iafilm-makers/Mod-8-film/README.md

The Mod-8 Project aims to improve Super-8mm filming, and rescue old cameras with dead motors:<br />
Use modern drives, eg stepper motors, so we can eliminate the sprocket holes. <br />
That saves space. Use that space to go 16:9 widescreen.<br />
Modify and Modernise so call it Mod-8.<br /><br />

Code is licensed under the MIT license<br />
Documents and designs are licensed under CC-BY-4.0<br />
