iafilm-makers/Mod-8-film/Mod-8-Camera-Circuits.pdf

Camera “Prototype One” – modified Sankyo 620 Supertronic.

Version 01 of 17 May 2026

This document covers circuits and circuit building.

See other document “Mod-8 - Super-8mm Camera Mods.pdf” for the craft of camera modification.

Photo: This is a complex circuit!
It worked well for me to build by planning with simpler diagrams of separate sections.

Use of old bell wire. I have many scrap boxes of parts from parents, grandparents and other extended family. This included bell wire where the core is a single thick copper wire. This is rigid and a tight fit into breadboard holes. I think that this gives robust breadboard prototyping for a working portable camera.

Wire colours convention:
I follow this by colouring white bell wire with permanent marker pen.
Implementation is not quite perfect. On the TODO list is painting some wires.
Red | Vcc positive – camera original power supply of 6 x NiMH batteries giving about 7.5V
Orange | 5V digital electronics power
Yellow | INPUTs into MCU
White | OUTPUTs from MCU

A4988 stepper
motor driver for
film advance.

MCU “Nucleo”
STM32-F303K8

“debouncing” for
shutter contact
breaker.

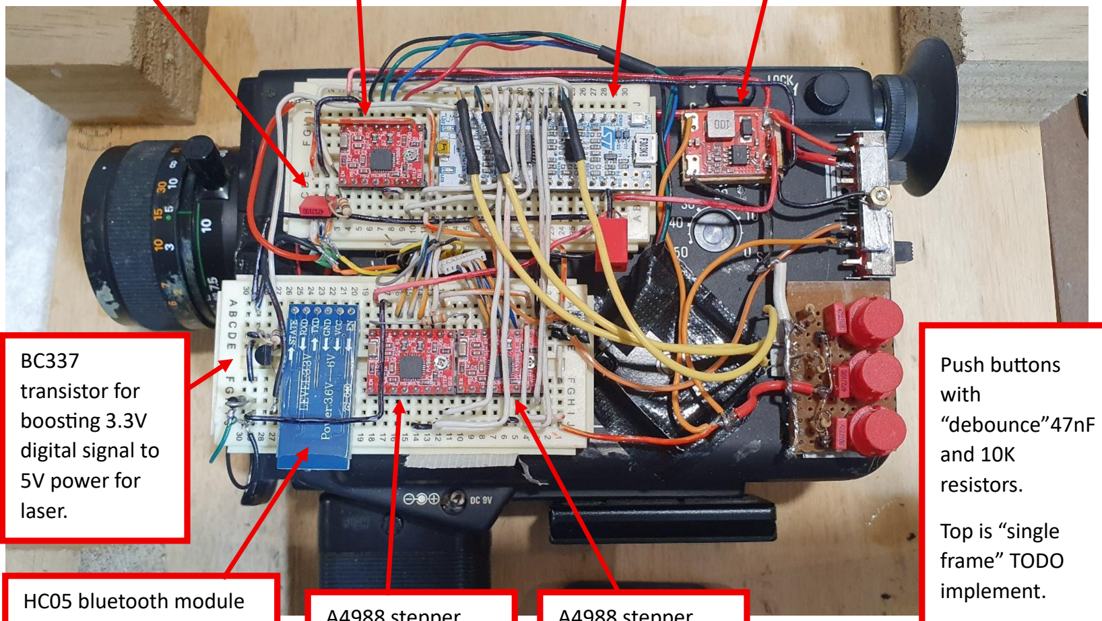
[picture p1: figure]
BC337 transistor for boosting 3.3V digital signal to 5V power for laser.; HC05 bluetooth module; Push buttons with “debounce”47nF and 10K resistors.; Top is “single frame” TODO implement.

not connected yet.
For future control and
monitoring by mobile
phone.

A4988 stepper
motor driver for
shutter motor.

A4988 stepper
motor driver for
aperture control.

DFRobot DFR0571 Buck
5V Power Module

Lower two are
aperture open
and close.

I found this useful to print on paper as the main diagram to work from

ADVANCE_SIGNAL = 2;

SINGLE_FRAME = 3;

STEP_APERTURE = 4;

DIR_APERTURE = 5;

STEP_DRIVE = 6;

DIR_DRIVE = 7;

STEP_SHUTTER = 8;

DIR_SHUTTER = 9;

REGISTRATION_MARK
= 10;

APERTURE_PLUS
= 11;
APERTURE_MINUS
= 12;

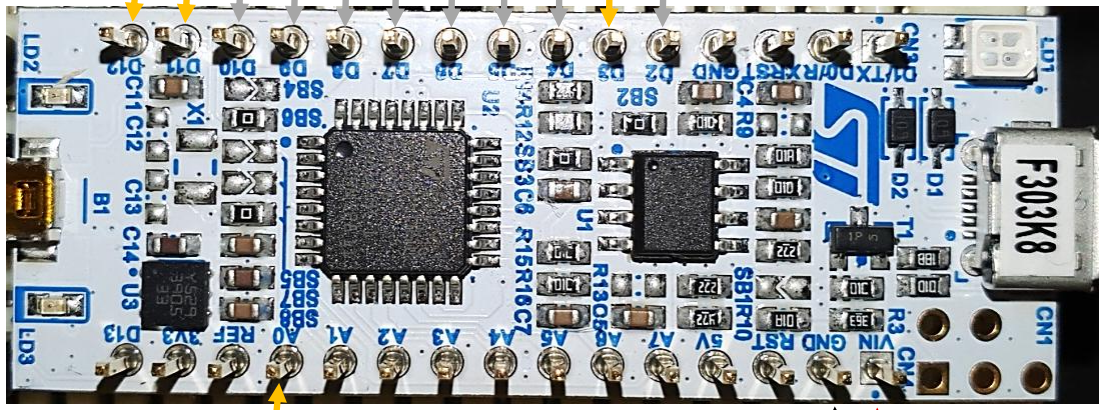
[picture p2: figure]

RUN_SWITCH = A0;

GND VIN

Circuit diagram, partial for clarity

Showing detail wiring of A4988 for the main film drive. The others are similar.

Wire colours:

Red | Vcc positive – camera original power supply of 6 x NiMH batteries giving about 7.5V
Orange | 5V digital electronics power
White | OUTPUTs from MCU

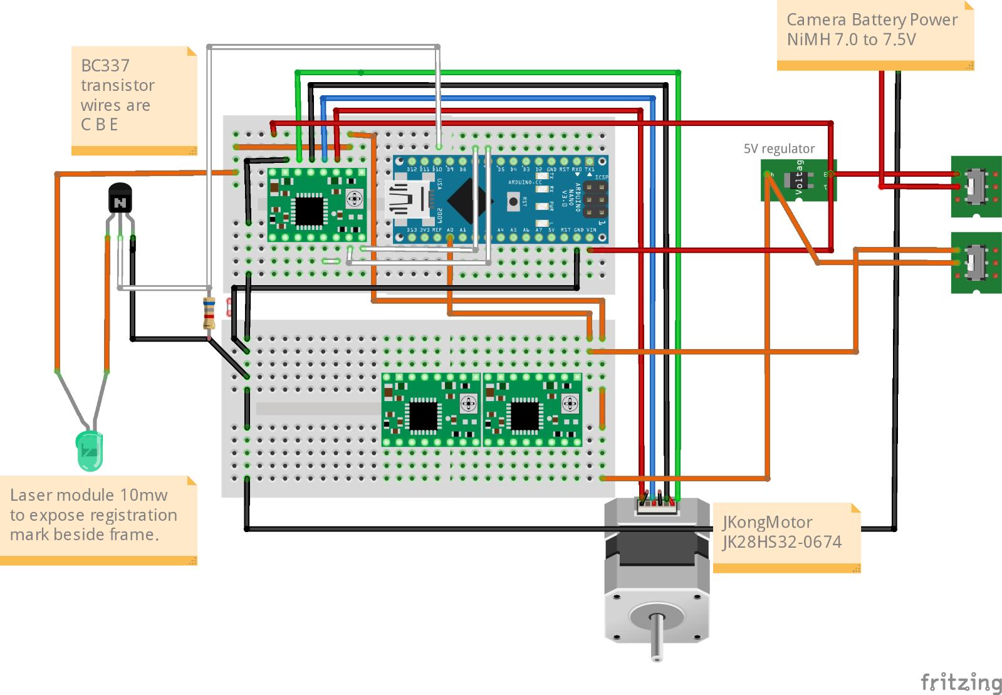
[picture p3: figure]
