iafilm-makers/Mod-8-film/Mod-8-Super-8mm Camera Mods.pdf

Mod-8 - Super-8mm Camera Mods
Example – “Sankyo 620 Supertronic”.
v01 – 2026-03-29
© 2026 by John Calder. Licensed under CC BY 4.0 Creative Commons Attribution.
More at the end of this document. In brief: cite mod-8-film.com
GUIDELINES ONLY: this what works for me but this is only one of many inputs and experiences that you need to develop your skills and capabilities.
SAFETY: Follow tool safety instructions, e.g. wear eye protection when cutting, drilling and grinding. Think “where is this going if it slips” e.g. cut in a direction away from yourself.
Wear protection e.g. gloves when handling glues, cleaning liquids and other things bad for our skin. Audiences:
- “Mod-8” - Makers modifying cameras to full “Mod-8” specs.
This extends the image size from 5.7mm x 4.1mm to 7.3mm to 4.1mm
and widens the range of film sources because we no longer need sprocket holes.
- “Upgrade” - Makers and camera owners using “spinoff discoveries” from the Mod-8 project to rebuild cameras to continue operating with classic format Super-8mm film.
In both cases we replace 45-60 year old motors, actuators and circuit boards with modern stepper motors and Arduino-programmed development boards. This gives the camera crystal-controlled accurate speed because development boards include accurate timing via crystal.
First up is a Sankyo 620 because it happens to be my available dead camera.
It is complex, advanced and compact. I am guessing that most cameras will be easier to work with than this one. However it does have some pleasant surprises.
Overview
Audience | Task | Case Sankyo 620
Both | Replace main drive motor | Easy Vitech 20BY Mini stepper motor is slightly smaller than the original motor. Its gear wheel matches the teeth of the Sankyo drive. It is an easy “drop in” replacement.
Both | Aperture control - manual | Intermediate Replace actuator with a micro stepper motor. Lucky that this comes with a gear wheel that matches the teeth of the Sankyo aperture drive. Note: some older simpler cameras have manual operation that needs no change.
Both | Aperture control – automatic - OPTIONAL | Not attempted at time of writing. I plan to use a separate light meter. Sankyo 620 has a sensor. TODO analyse what it does. It could be a photoresistor, photodiode or phototransistor.

Mod-8 | Widen the gate from 5.7mm to 7.3mm. The height stays at 4.1mm | Easy (as in surprisingly easy) I made a tool out of basswood, sanded it to 4.1 mm thick, glued sandpaper on the edge and got to work sanding evenly on both sides.
Mod-8 | Remove film advance claw and related mechanical parts | Challenge Sankyo 620 has a complex drive to provide a “lap dissolve” special effect. Need to identify, remove and scrap most of those parts and superglue the film take-up tailshaft into its normal run position.
Mod-8 | Provide a timing device on the shutter drive to trigger film advance | Easy Sankyo 620 already has a “flash trigger” switch that can do this. The only change needed is to reposition the timing gear to “fire” on shutter close rather than shutter open. This is a lot like configuring timing gears on classic cars and motorbikes.
Mod-8 | Convert sound drive to film transport drive | Intermediate Remove guides and sound heads. Remove capstan and pulley – replace with a stepper motor and shaft sleeve.
Mod-8 | Modify film cartridge for new film transport and reloadability. | Intermediate Add idler pulley and precision-drill registration dot hole
Mod-8 | Setup a light source to expose a registration mark beside each film frame. | Intermediate I zap the film with a very low power 10mW laser module of the kind used for laser pointers. Sankyo 620 has a sound drive motor that is no longer needed, remove that to make a good space for the laser. I needed to create a jig to precisely drill a 0.5mm diameter hole in the lower front of the film cartridge.

Toolkit
My setup is an average home workbench with common small tools, especially:
- Jewellers screwdrivers
- Tweezers – thin nose
- Electric drill and/or Rotary Tool.
- Engraving tool for small object grinding – this can be a Rotary Tool with engraving bits.
- Secure work holding devices:
- Vise – essential.
- Other holding device – I mostly use a retort stand. It has also worked to use lengths of wood with holes drilled, fastening the parts on with cable ties.
- Electronic Caliper measuring tool. Now affordable and highly recommended.

Drilling holes accurately is a challenge for me.
I have a friend with a drill press so I have been visiting him.
I have also made ad hoc “jigs” out of scrap materials to line parts and tools up.
Note
Where I mention product names below, they just happen to be what has worked for me. I do not seek or get any endorsement sponsorship.
Glues
Epoxy resins – I am using “JB Weld Original” and “Araldite Ultra Clear”
Superglue – I am using “Bostik”.
Neoprene contact adhesive – I am using “Ados F2”
Lubricants
Oil – I am using “Singer Sewing Machine Oil”
Grease – I am using “WD 40 3-in-1 White Lithium Grease”.

About Super-8 cameras
Not experienced with dismantling these? It is good to have general small parts repair or building experience e.g model aircraft, robotics making.
AND/OR make sure you buy “untested” cameras at low cost and expect to have learning time with the first one (or more!) that may end up as a parts supply for what comes later.
Common Module Layout (exploded schematic, top view)

Side Cover (Film door side)

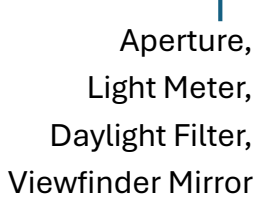
[picture p4: figure]
Aperture, Light Meter, Daylight Filter, Viewfinder Mirror

Side Cover

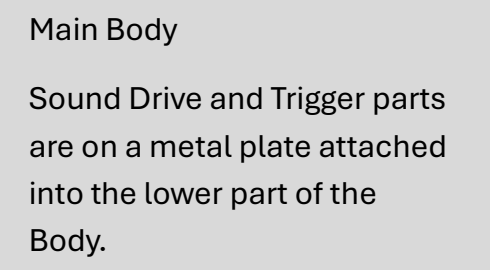
[picture p5: figure]
Main Body; Sound Drive and Trigger parts are on a metal plate attached into the lower part of the Body.

Prime
Lens,
Shutter,
Claw

Zoom
Adapter

Example Sankyo 620
Organising work
I use “organiser” boxes with compartments for the above modules and sub-modules.
I write little cards to go in the compartments with the screws etc.
The unmarked compartments in this image are holding surplus parts not needed for Mod-8.

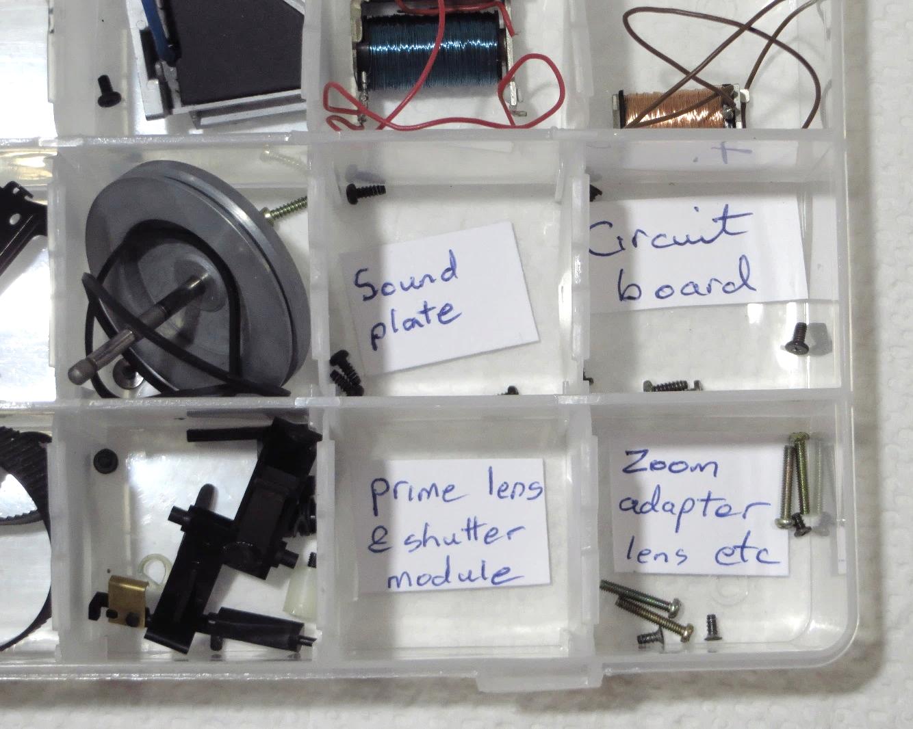
[picture p6: figure]

General hints for dismantling

- Most modules are attached by screws. There are often a mix of short and long screws. To easily get them back to matching holes, as we remove long screws, mark their holes with small pieces of masking tape.
- If a module or large part will not loosen, wiggle edges of it to find out where it is tightly held. Look more closely there for a fastener.
- Some screws are hidden under “leatherette”, decorative areas that peel off like sticky tape.
- Most knobs, switches and other controls are fixed to a module, mostly side covers, and do not need removal. They have “dogs” (protruding pins) that fit into slots in the part below and simply unclip on cover or module removal.
- Most control panels are part of the module below and the cover we are removing has a cutout. But be on the lookout for exceptions. E.g the Bell and Howell MS45 uses the ring nuts on electrical sockets as cover fasteners.
- Remove modules slowly looking for springs, wires, mechanisms that we need to unhook. The most common examples are the controls for the daylight filter. The Sankyo 620 has a white nylon rod that needs to be flexed out of the way to allow the zoom adapter module to get clear of the body.

Sankyo 620 with side covers removed.

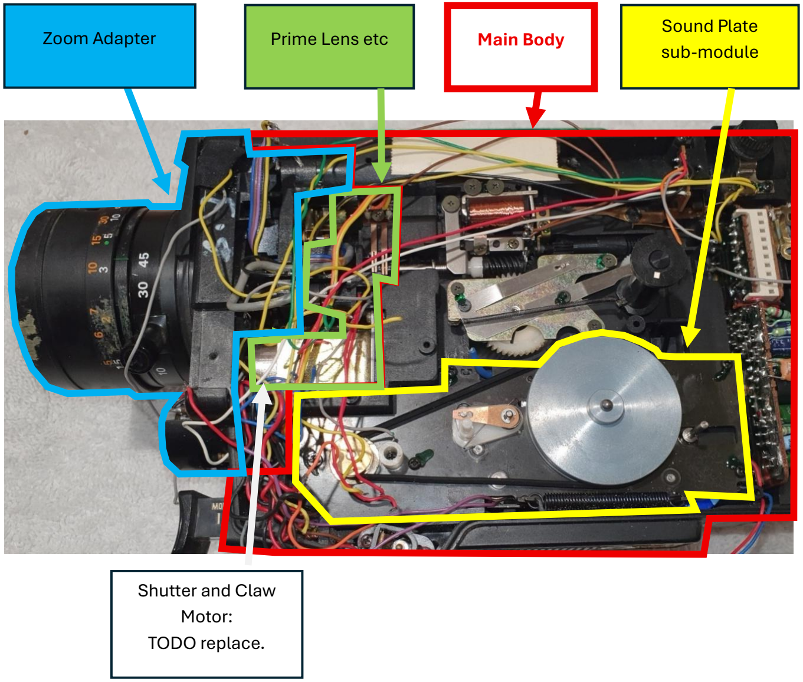
[picture p7: figure]
Zoom Adapter; Prime Lens etc; Main Body; Sound Plate sub-module; Shutter and Claw Motor: TODO replace.
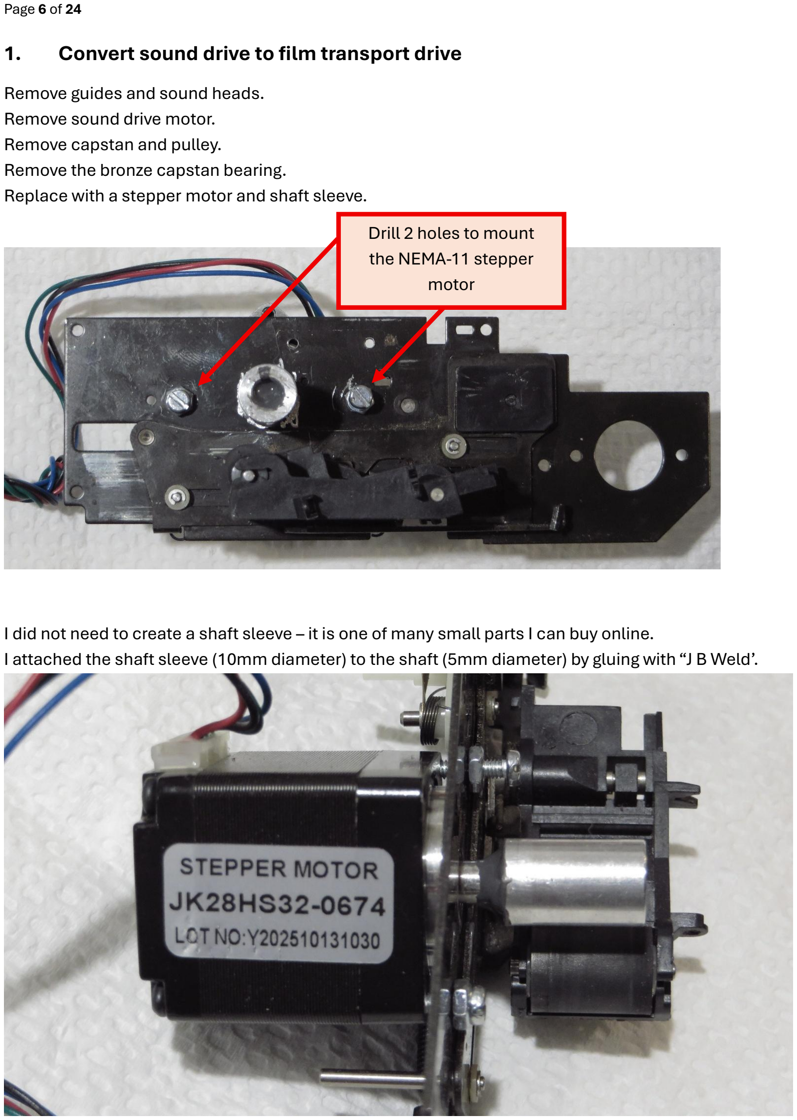
[picture p8: page 6]

### 1. Convert sound drive to film transport drive

Remove guides and sound heads.
Remove sound drive motor.
Remove capstan and pulley.
Remove the bronze capstan bearing.
Replace with a stepper motor and shaft sleeve.

I did not need to create a shaft sleeve – it is one of many small parts I can buy online.
I attached the shaft sleeve (10mm diameter) to the shaft (5mm diameter) by gluing with “J B Weld’.

Drill 2 holes to mount
the NEMA-11 stepper
motor

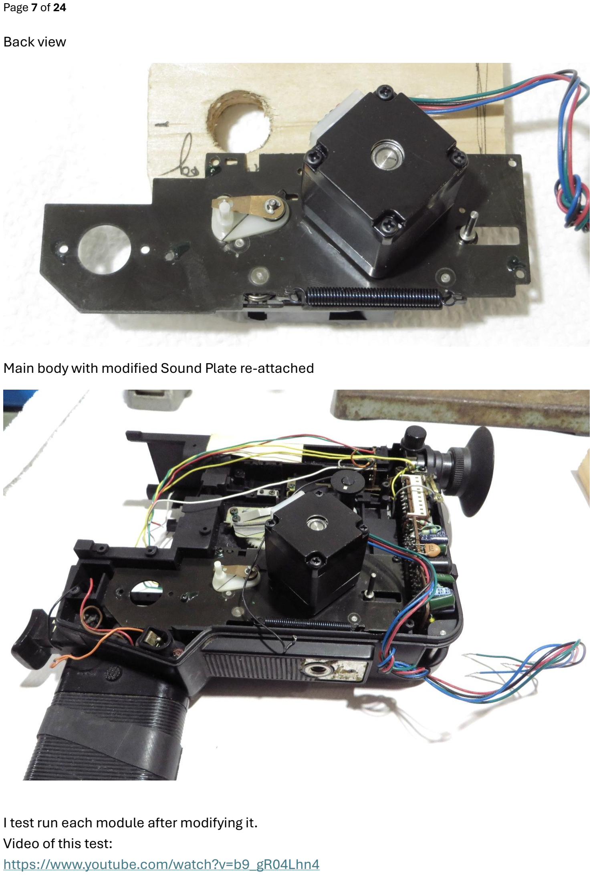
[picture p9: page 7]

Back view

Main body with modified Sound Plate re-attached

I test run each module after modifying it.
Video of this test:
https://www.youtube.com/watch?v=b9_gR04Lhn4

### 2. Modify Sound Cartridge(s)

2.1 Make reloadable.
If interested in filming with the outdated film in the cartridge, do that first.
1. Break the take-up spool ratchet by forcing it anti-clockwise (reverse of its intended movement).

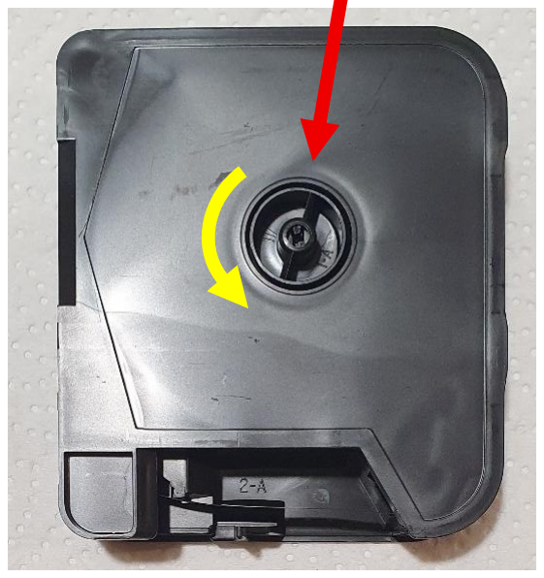
[picture p10: figure]

1A. Pull out any exposed film in total darkness through the sound area. Note, removal of film like this works better for sound cartridges than silent because the sound exit path is shorter with less in the way of friction points.

2. On pulling out film, proceed slowly and carefully near the end so the film end
| remains attached to the take-up spool. LEAVE at least 200mm (about 8 inches) of film for re-threading the cartridge on re-loading.
3. Cut the film supply chamber cover to make it removeable.
| Cut 6mm back from the angled front shape using a rotary tool miniature rotating cutter. This is also possible with a craft knife but that takes a long time with many repeated cuts through strong plastic. Warning! Care! high risk of the craft knife slipping and cutting us. Then run a craft knife tip around the outside edge groove to make it a little easier to crack off. Crack off the cover by levering with a screwdriver starting at the ends of the across cut.

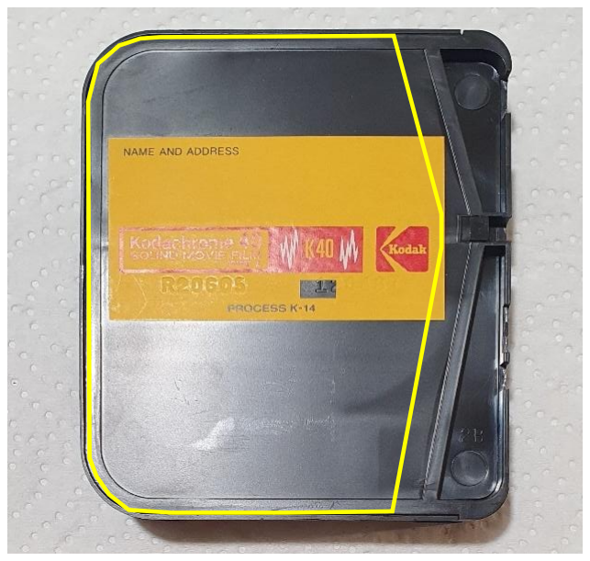
[picture p11: figure]

### 2.2 Add Idler Pulley

I source these from Aliexpress https://www.aliexpress.com/item/1005006368974548.html
Link as at 27 Mar 2026. Links to a catalogue where products and links often change. Search keywords include: pinch roller tape recorder

Size is 13mm diameter, 8mm hub
length with a 6mm wide rubber tyre,
2mm centre hole.

Fit the roller into the bottom front of the cartridge by drilling a 2mm hole through.

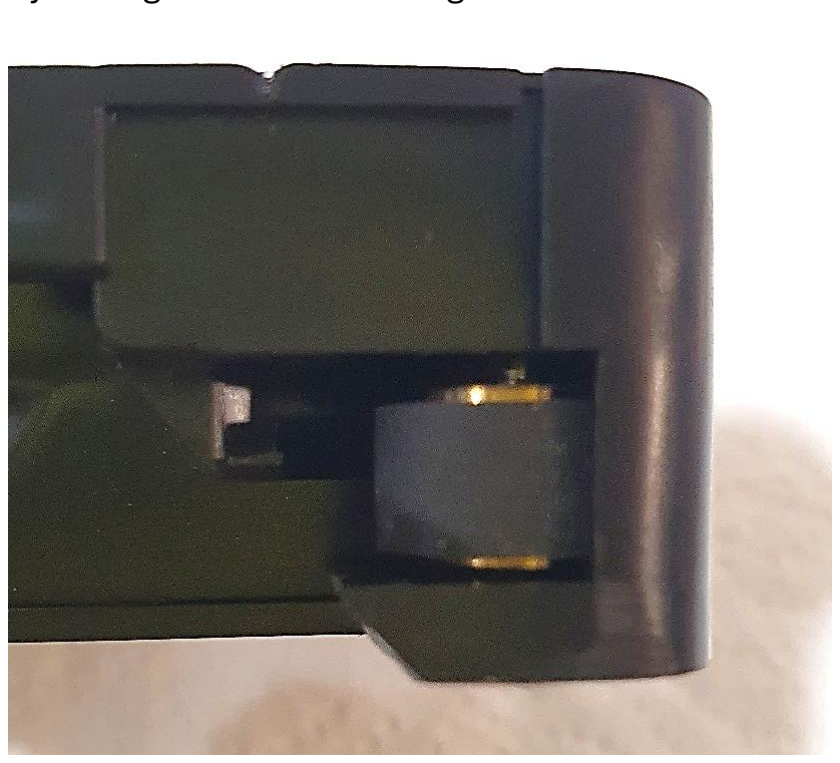
[picture p12: figure]
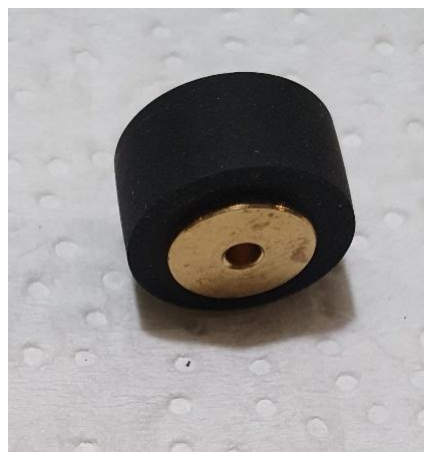
[picture p13: figure]

Hole position is 8mm from the bottom and 8mm from the front.
I could not find a handy shaft with diameter of 2mm.
A friend found 2mm diameter nails in his scrap box so I used those. I hold the shaft in place with “J B Weld” epoxy resin glue.

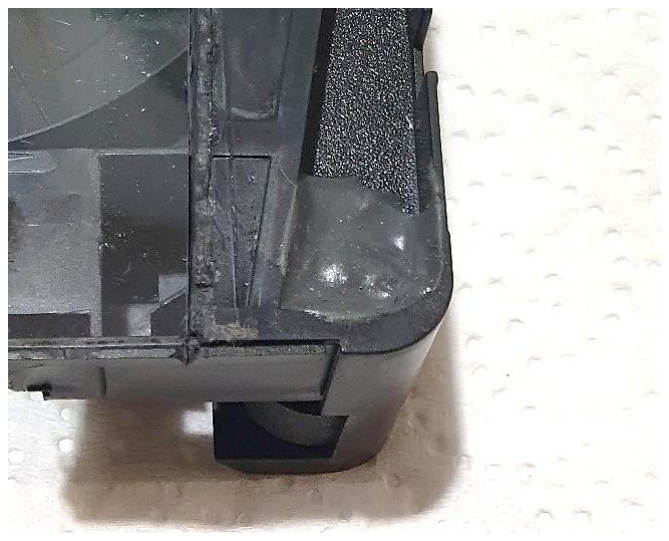
[picture p14: figure]
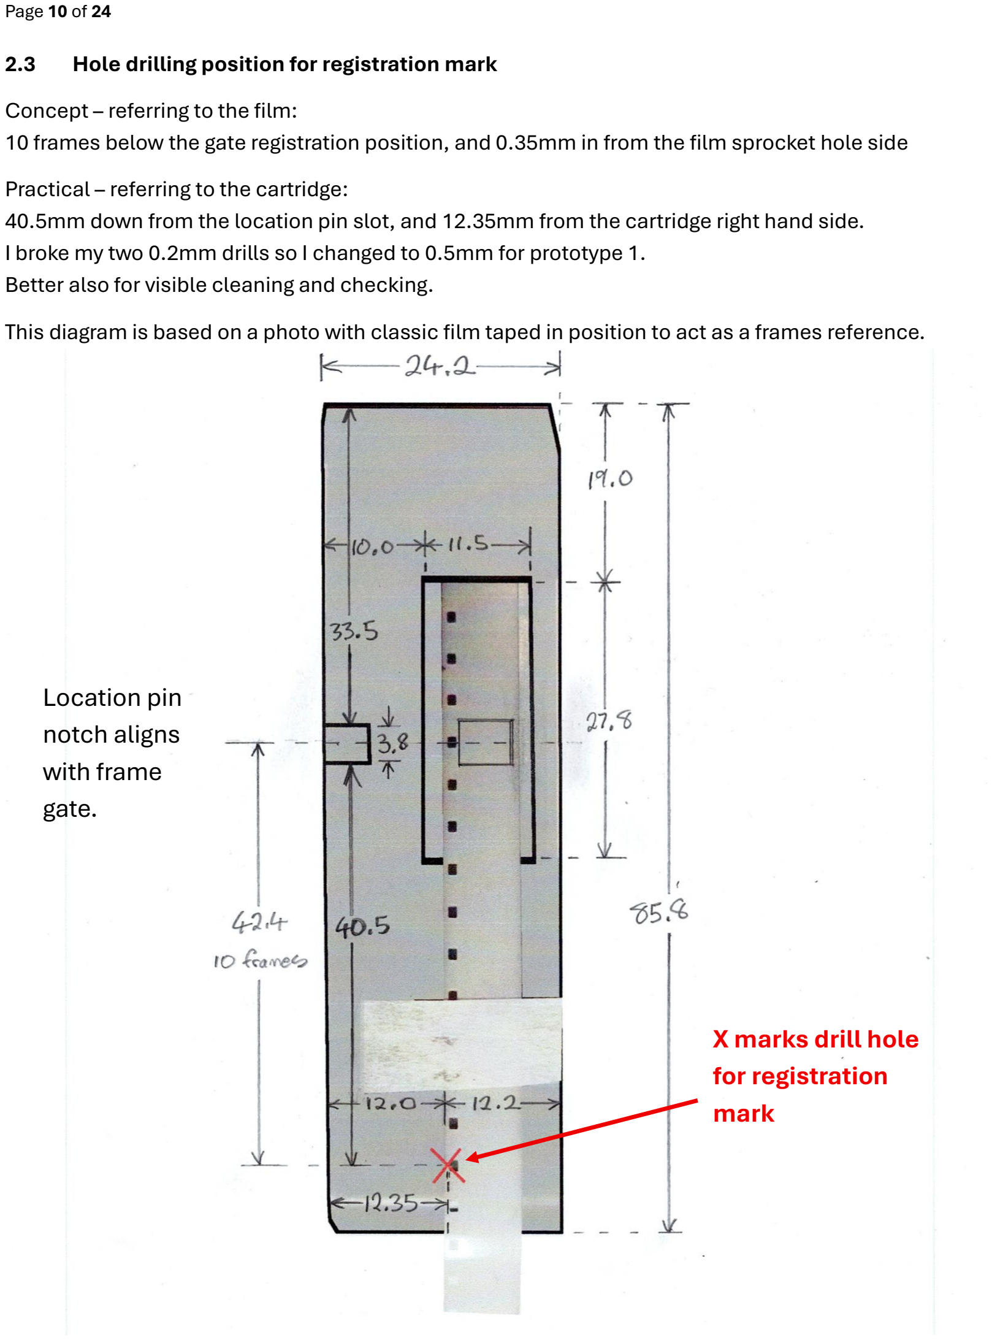
[picture p15: page 10]

### 2.3 Hole drilling position for registration mark

Concept – referring to the film:
10 frames below the gate registration position, and 0.35mm in from the film sprocket hole side Practical – referring to the cartridge:
40.5mm down from the location pin slot, and 12.35mm from the cartridge right hand side.
I broke my two 0.2mm drills so I changed to 0.5mm for prototype 1.
Better also for visible cleaning and checking.
This diagram is based on a photo with classic film taped in position to act as a frames reference.

Location pin
notch aligns
with frame
gate.

X marks drill hole
for registration
mark

### 2.4 Setup a light source to expose a registration mark

I “zap” the film with a very low power 10mW laser module of the kind used for laser pointers. Sankyo 620 has a sound drive motor that is no longer needed.
I remove that to make a good space for the laser.
The laser unit does not emit a simple very narrow beam as I expected. I think it is acting like a micro projector focussing many beams from a diode area to a distant dot. I therefore needed to focus that image very close to the unit. I modified the unit with a piece of 4mm brass tubing acting like a photography “extension tube”.

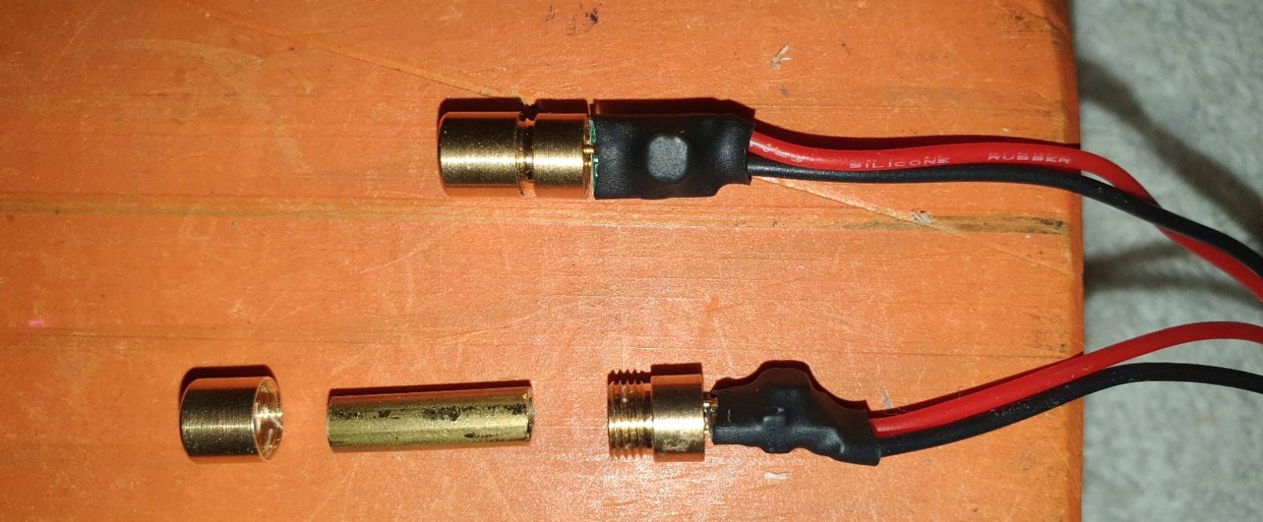
[picture p16: figure]

Laser unit in place after removing the sound drive motor and drilling a hole through from the front to the film chamber. Scrunched up foil helps with holding in place. It also has a heat sink role.

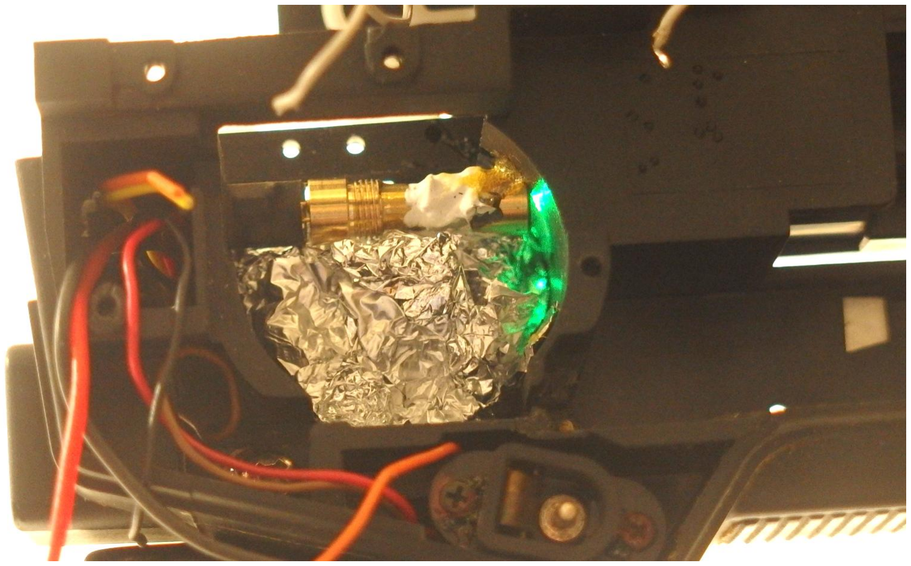
[picture p17: figure]

Laser shining into the film compartment (green light).
The small drilled hole in the cartridge lines up with the light source in a first attempt to achieve a registration mark.

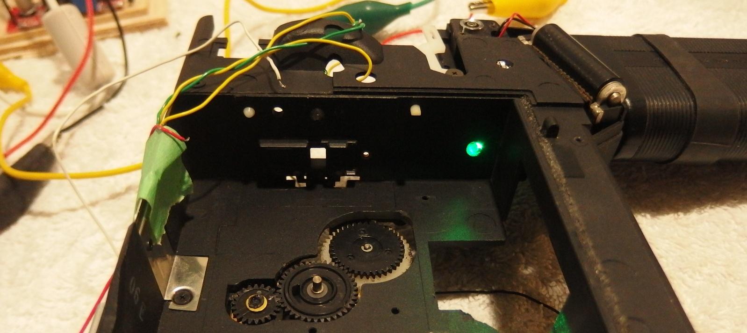
[picture p18: figure]

Drilling the hole (4mm diameter) through from the front hit a challenge with the curved plastic in the back of the motor chamber. This put sideways pressure on the drill tip.
I needed to “dig” a little starter opening there using a rotary tool with a small grinding spherical tip.

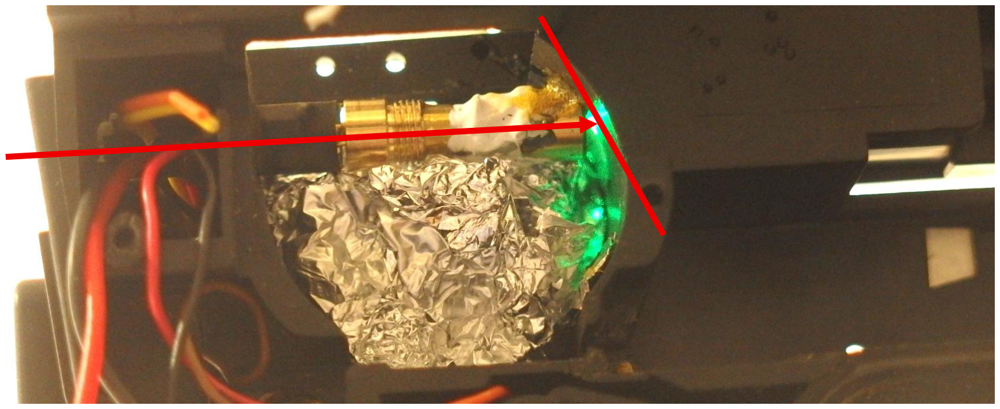
[picture p19: figure]

As at the end of March, 2026, this is looking like the mod most in need of work.
Depending on what results this gets, other ideas to try include:
- Locate registration mark-making parts inside the cartridge
- Light mark delivery by glass fibre “light pipe”. This may make it possible to locate mark delivery in the gate slot vacated by removing the claw.

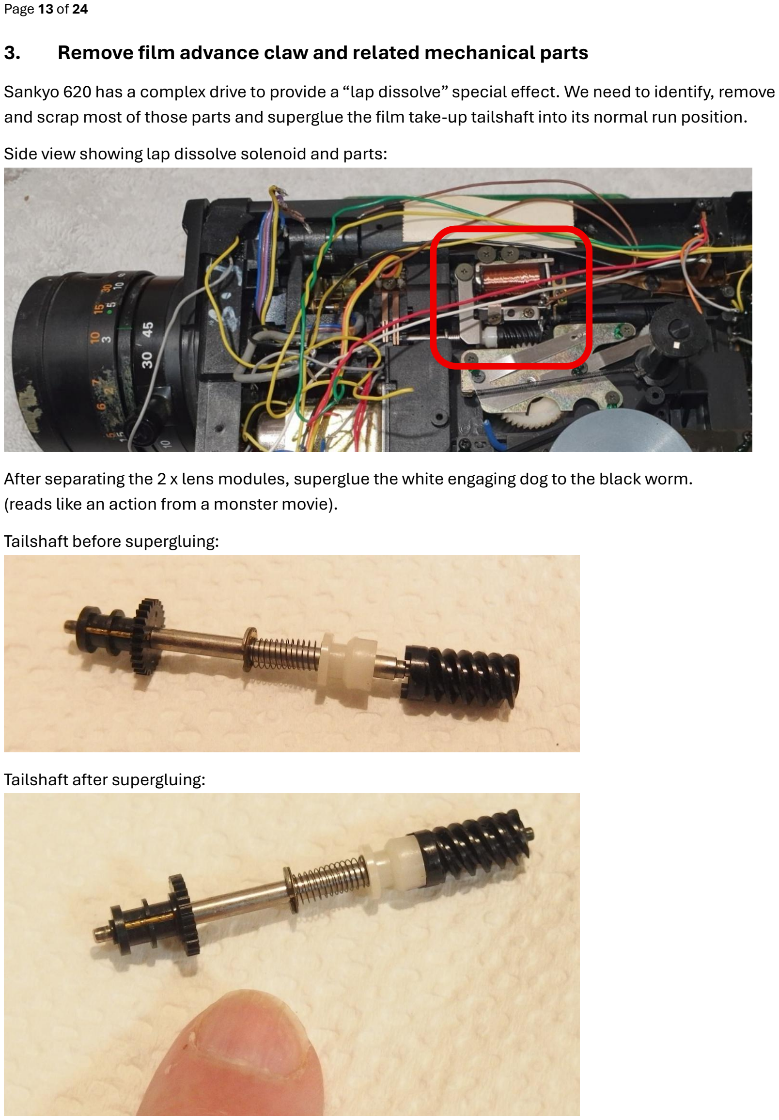
[picture p20: page 13]

### 3. Remove film advance claw and related mechanical parts

Sankyo 620 has a complex drive to provide a “lap dissolve” special effect. We need to identify, remove and scrap most of those parts and superglue the film take-up tailshaft into its normal run position. Side view showing lap dissolve solenoid and parts:

After separating the 2 x lens modules, superglue the white engaging dog to the black worm. (reads like an action from a monster movie).
Tailshaft before supergluing:

Tailshaft after supergluing:

Remove the claw-cam piece with its attached spring.
There is a lot of grease on it and the body around the gate.
Clean that off – I use cotton buds and isopropyl alcohol.
Main body – gate and shutter area with the prime lens etc module completely removed

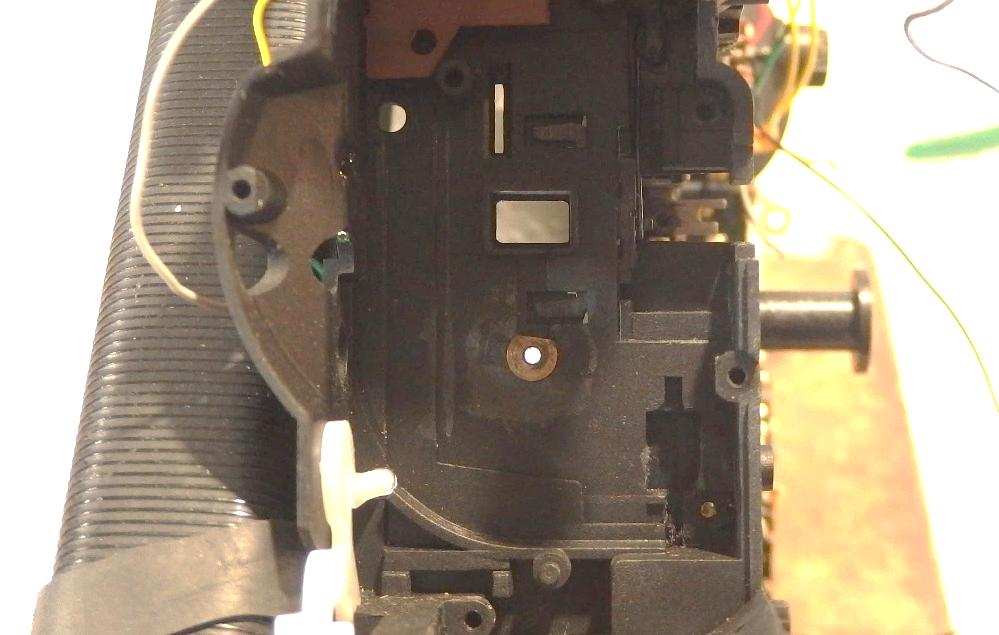
[picture p21: figure]

Trial fitting of the shutter

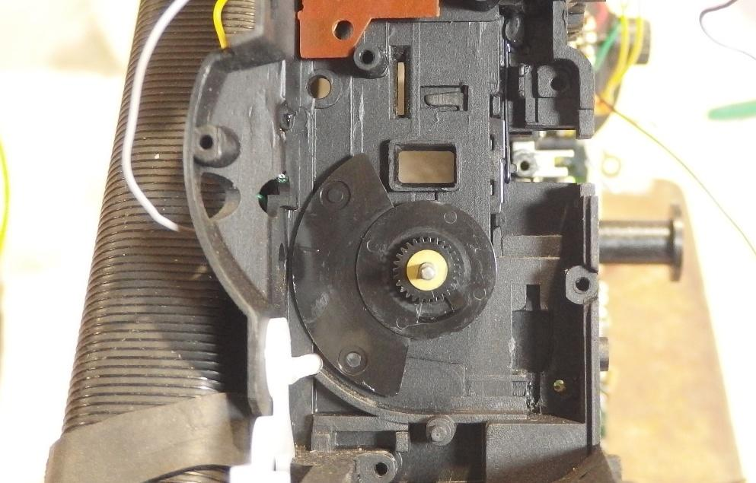
[picture p22: figure]

On trying to re-attach the prime lens etc block, it would not seat down on the body. The shutter shaft was pushing too far into the block.
I am guessing this had something to do with removing the claw-cam piece.
The prime lens etc block has an adjuster for shutter shaft end clearance. Unfortunately this was jammed.

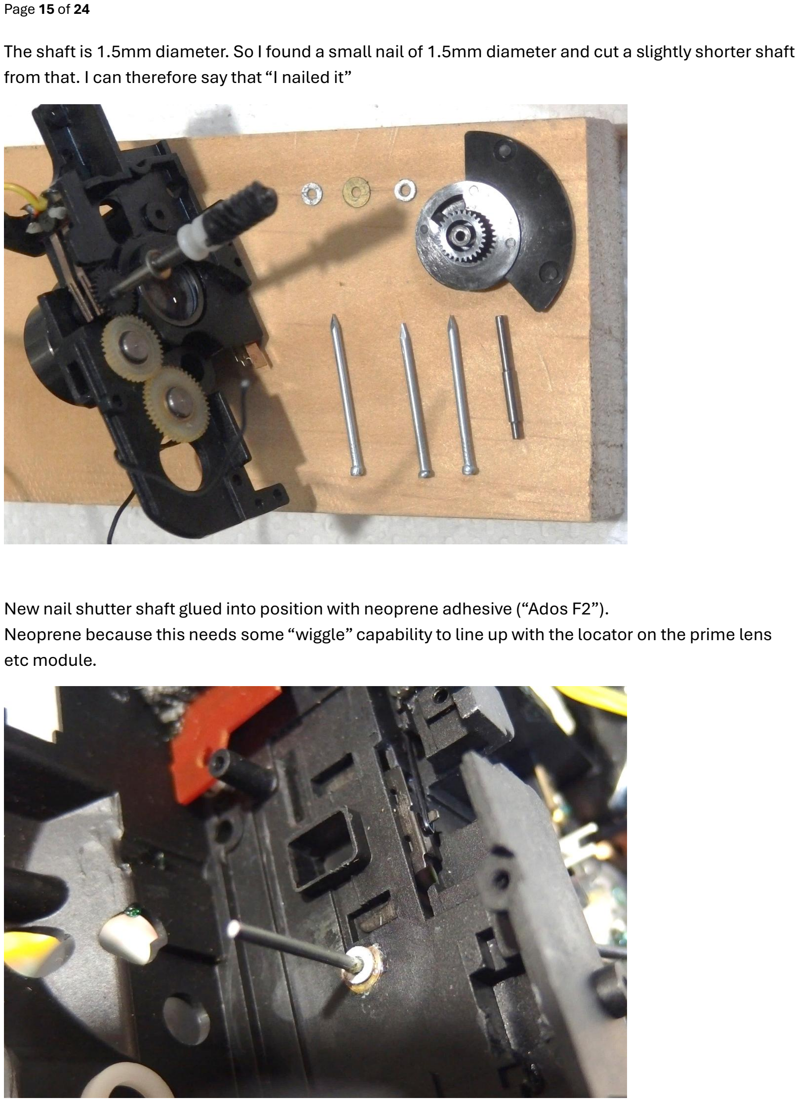
[picture p23: page 15]

The shaft is 1.5mm diameter. So I found a small nail of 1.5mm diameter and cut a slightly shorter shaft from that. I can therefore say that “I nailed it”

New nail shutter shaft glued into position with neoprene adhesive (“Ados F2”).
Neoprene because this needs some “wiggle” capability to line up with the locator on the prime lens etc module.

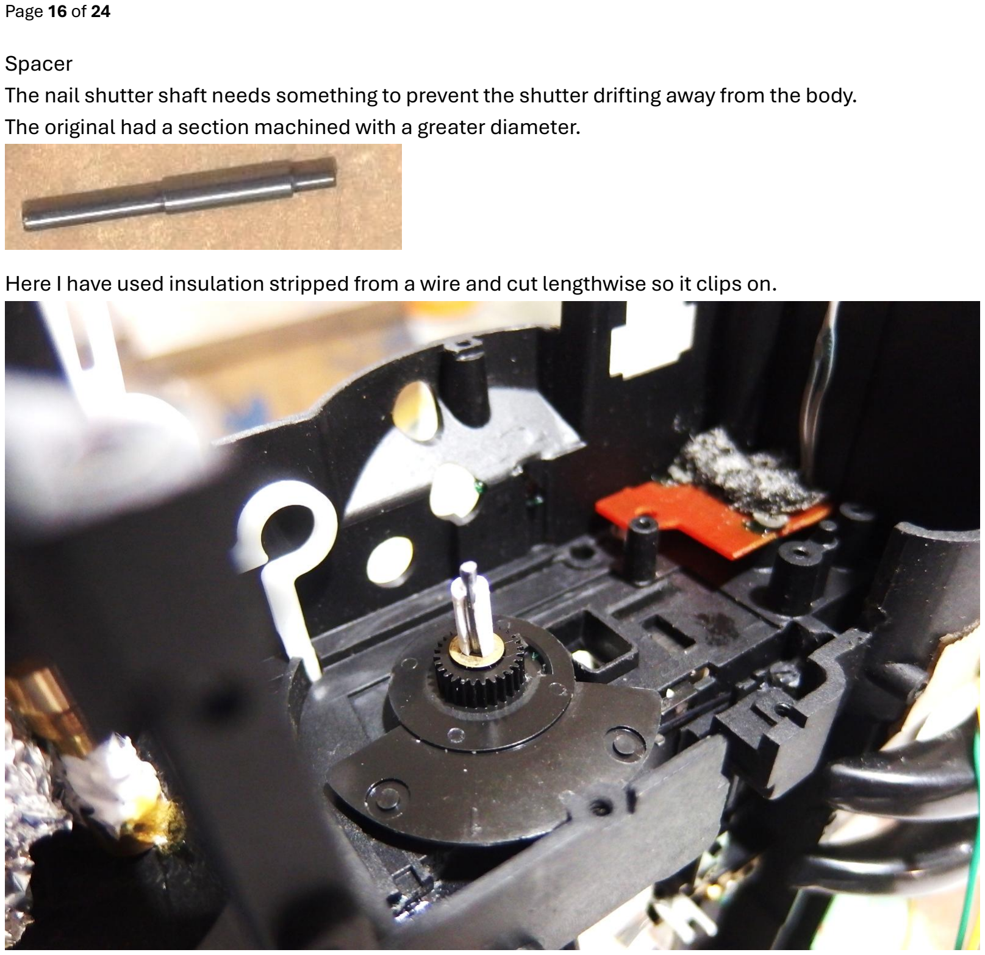
[picture p24: page 16]

Spacer
The nail shutter shaft needs something to prevent the shutter drifting away from the body. The original had a section machined with a greater diameter.

Here I have used insulation stripped from a wire and cut lengthwise so it clips on.

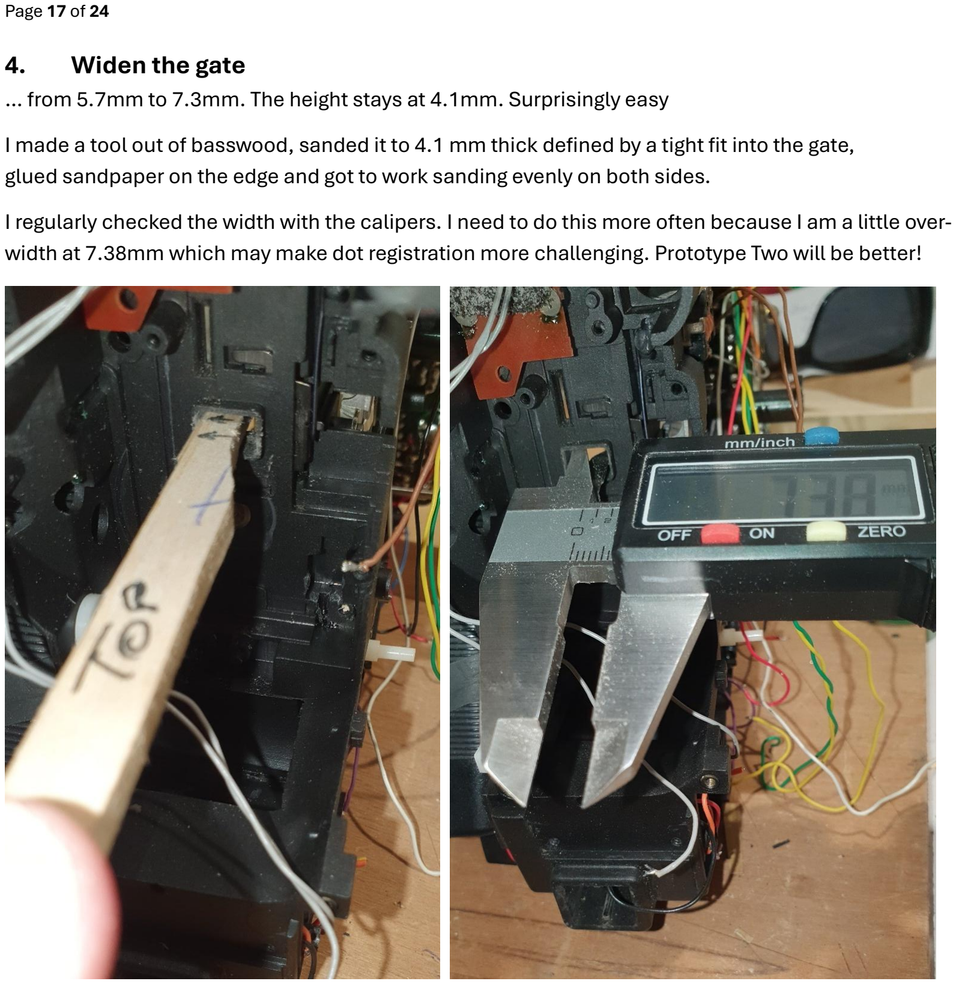
[picture p25: page 17]

### 4. Widen the gate

… from 5.7mm to 7.3mm. The height stays at 4.1mm. Surprisingly easy
I made a tool out of basswood, sanded it to 4.1 mm thick defined by a tight fit into the gate,
glued sandpaper on the edge and got to work sanding evenly on both sides.
I regularly checked the width with the calipers. I need to do this more often because I am a little over-width at 7.38mm which may make dot registration more challenging. Prototype Two will be better!

### 5. Replace Main Drive Motor

Vitech 20BY Mini stepper motor is slightly smaller than the original motor.
I sourced from:
https://www.aliexpress.com/item/1005008029922605.html
Link as at 29 Mar 2026. Links to a catalogue where products and links often change.
Its gear wheel “15 teeth / 0.3 Modulus” matches the teeth of the Sankyo drive.
It is an easy “drop in” replacement.
I file slots in the edges of the flange to line up with the screws designed for a larger flange.

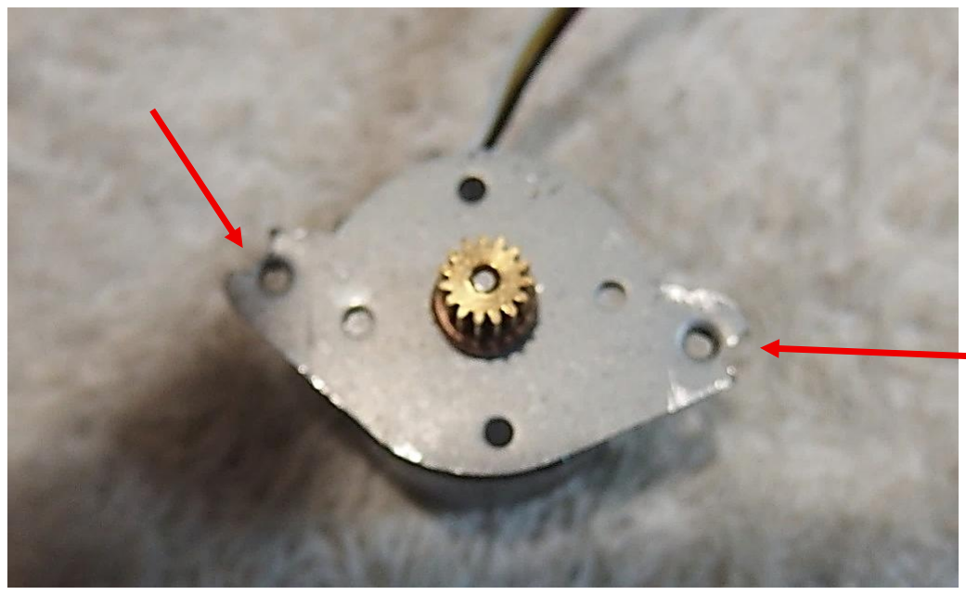
[picture p26: figure]

Vitech 20 goes here – view from film side

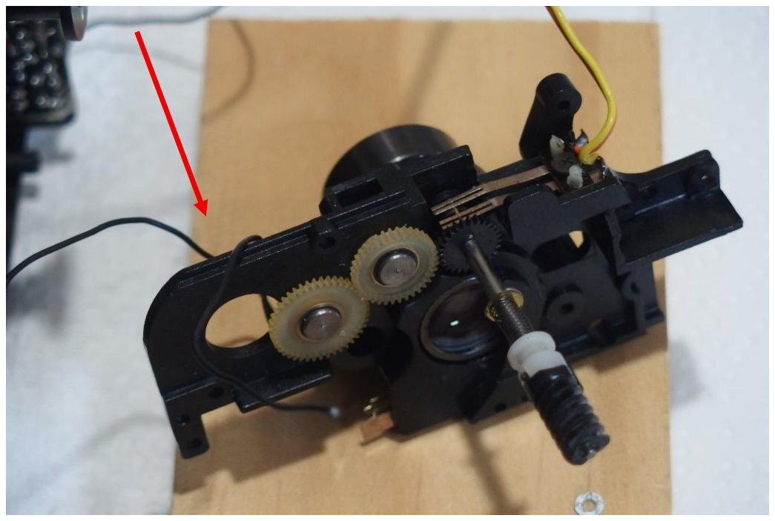
[picture p27: figure]
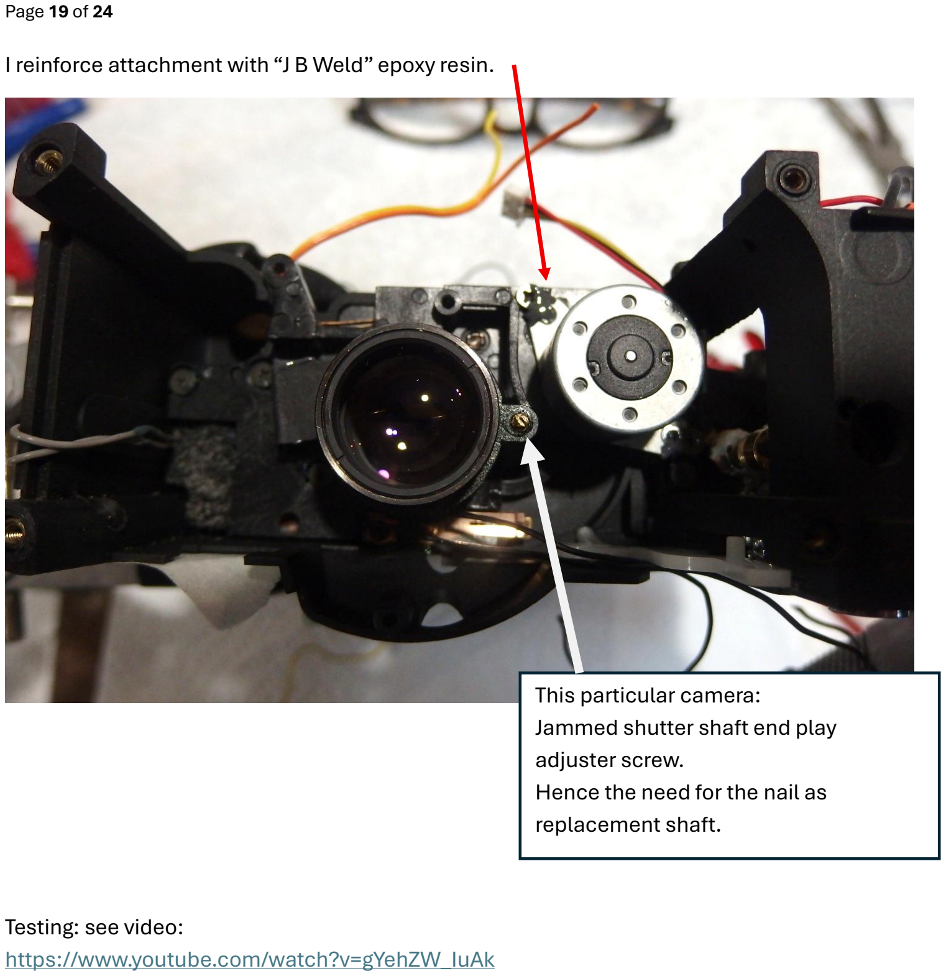
[picture p28: page 19]

I reinforce attachment with “J B Weld” epoxy resin.

Testing: see video:
https://www.youtube.com/watch?v=gYehZW_IuAk

This particular camera:
Jammed shutter shaft end play adjuster screw.
Hence the need for the nail as replacement shaft.

6. Provide a timing device on the shutter drive to trigger film advance.

Sankyo 620 already has a “flash trigger” switch that can do this. The only change needed is to reposition the timing gear to “fire” on shutter close rather than shutter open. This is a lot like configuring timing gears, or contact breaker timing, on classic cars and motorbikes.

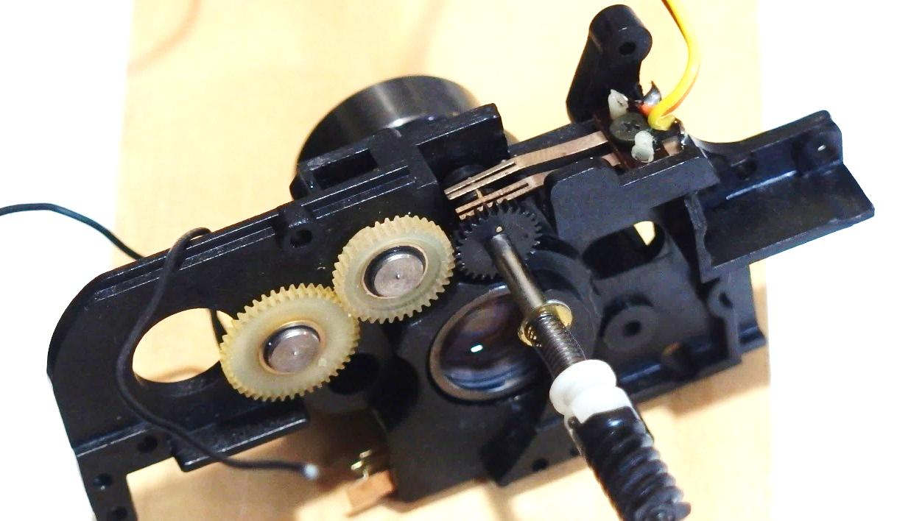
[picture p29: figure]
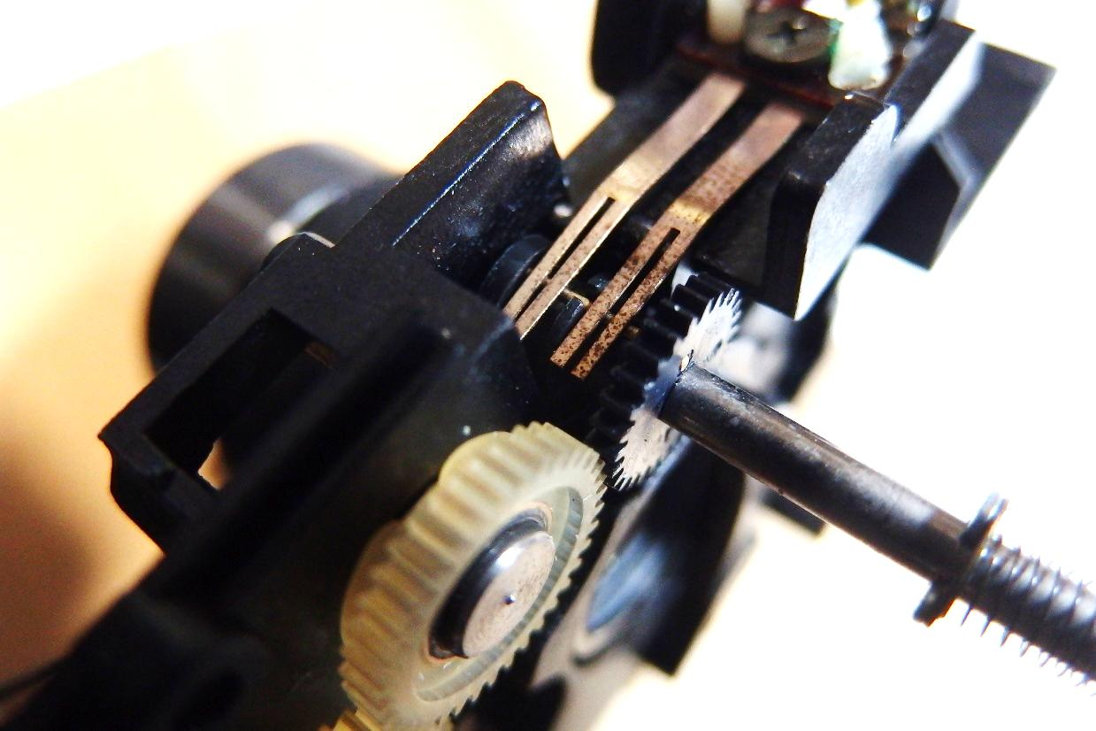
[picture p30: figure]

For reassembly:
Turn the tailshaft to the position shown.
The copper piece embedded in the shaft is making contact between the 2 “brushes”. Then position the shutter to just covering the gate – thinking rotation anti-clockwise. Assemble

7. Aperture needs to work.

Some older and simpler cameras are good to go with no work needed.
These often have manual controls where a knob is directly connected to the aperture, e.g. Sankyo XL40 S, Sankyo XL60 S
We may also get lucky and have a separate circuit board for light metering
and aperture actuation.
The opposite is Prototype One, which happens to be a Sankyo 620.
I thought that the actuator was a simple DC electric motor. That seemed to be its behaviour when alive. But it is a 1979 mystery artifact with 5 wires which I can make no sense of with my measuring and testing efforts.
Auditioning candidate actuators:

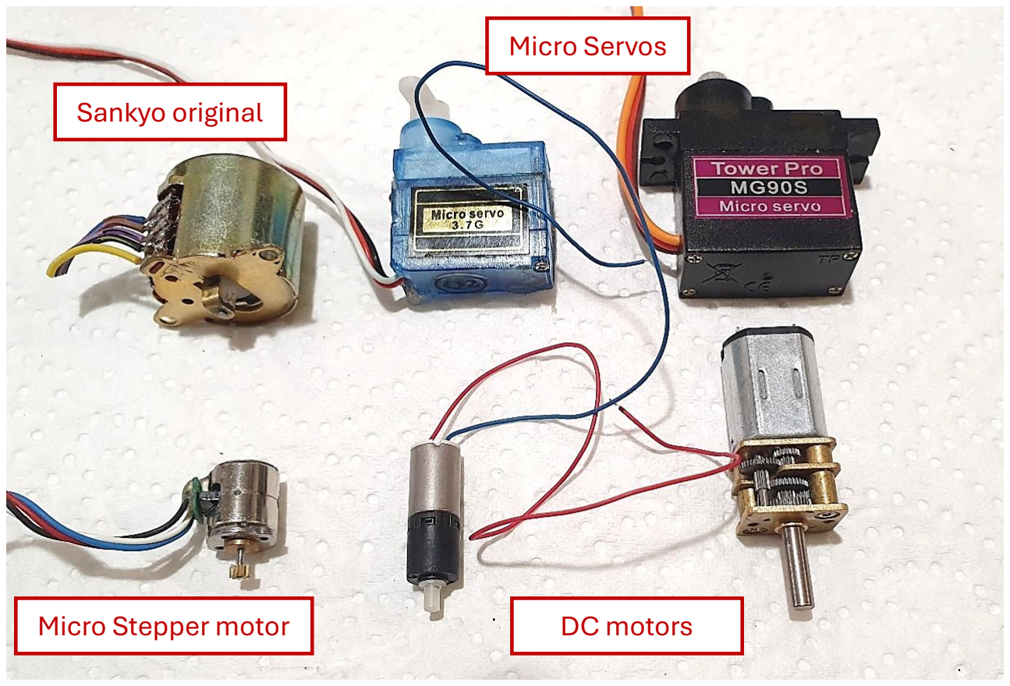
[picture p31: figure]
Sankyo original; Micro Servos; Micro Stepper motor; DC motors

The shortlist. I extracted the DC simple motor out of the above MG90 micro servo.

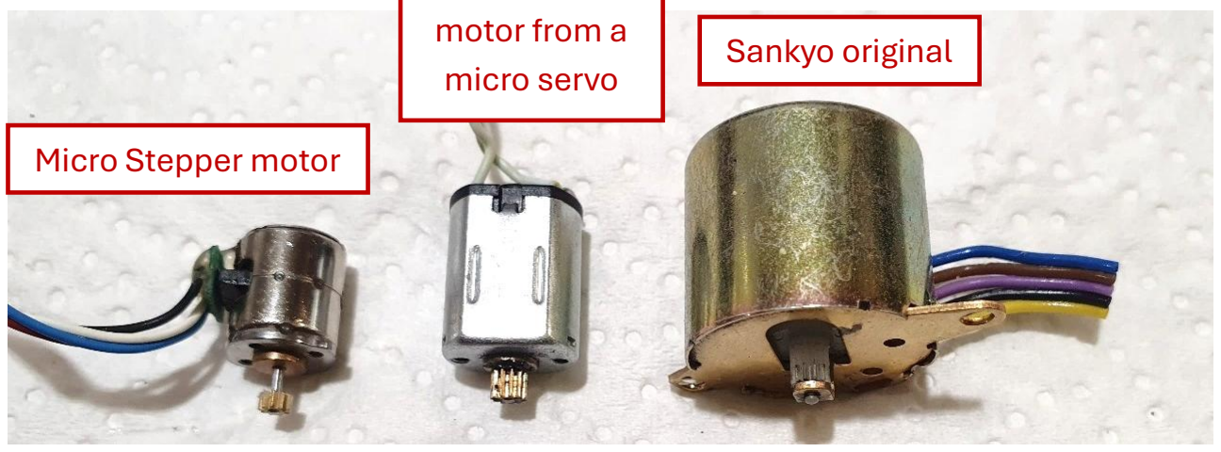
[picture p32: figure]
Micro Stepper motor; motor from a micro servo; Sankyo original

WINNER! The Micro Stepper motor!

DC simple

This was a close contest between the micro stepper and the simple DC micro.
The micro stepper is only slightly more complex to setup. It has excellent fine control and it has a gear wheel with a shaft position in a good place to engage the existing gears.
Source:
https://www.aliexpress.com/item/4000806393169.html
Link retrieved as at 27 Mar 2026. Links to a catalogue where products and links often change.
Search keywords include: micro mini 8mm stepper motor small
Drama! Removing the original actuator. I encountered a stuck screw. I needed to release the actuator by grinding the screw head off with a rotary tool. I was concerned about the dust from the grinding. I mounted the module up high so I could position it with the screw at the bottom and work on it from underneath. That way dust would fall down away from the module. I used masking tape to close the gap behind the screw. I taped a wet paper towel below the module to catch the dust.
Where eye protection for grinding operations like this.
Follow safety instructions that come with the tools.

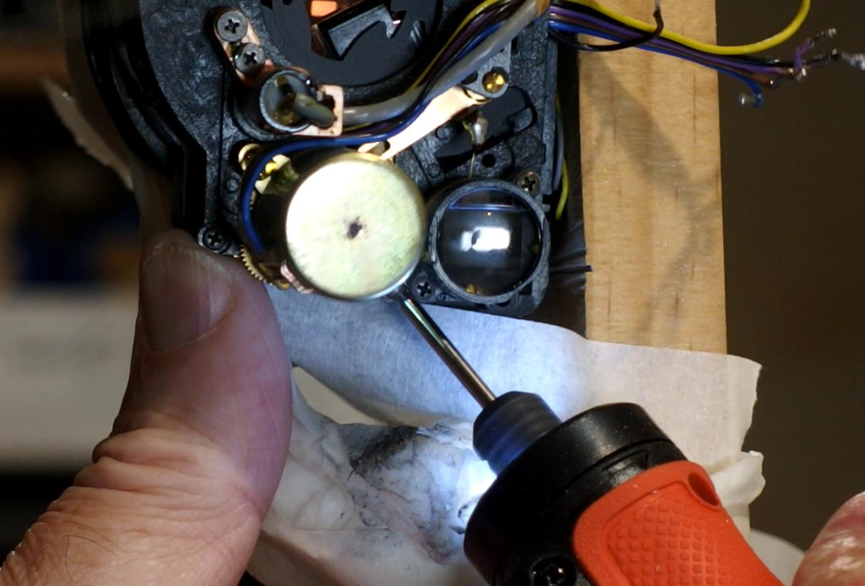
[picture p33: figure]

I reassembled the gear block using Araldite Ultra Clear epoxy resin glue to replace the lost screw and reinforce the other screw which now has a gap where the old actuator flange was.
I tested by holding the motor in the gear block while running it to find the best position.
I then superglued it in place. Following up with J B Weld Epoxy Resin glue.

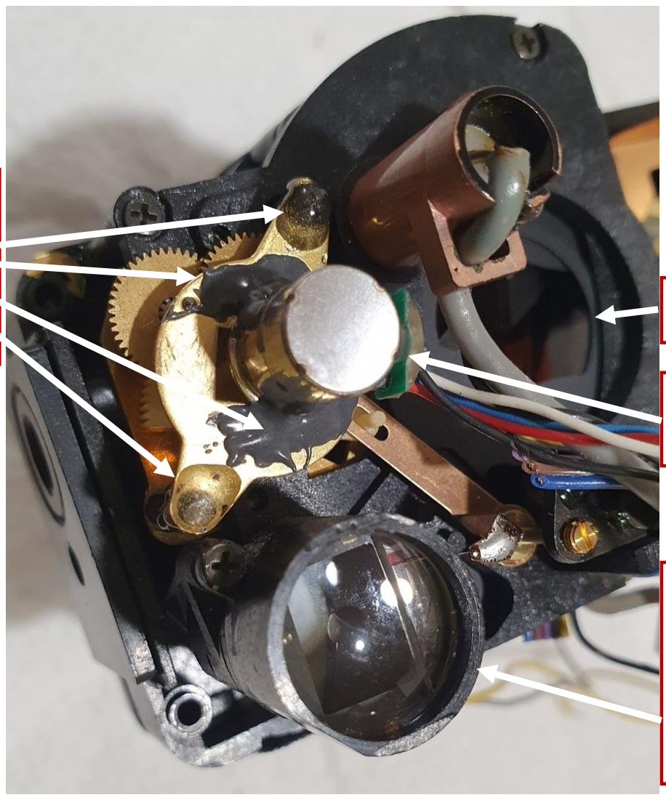
[picture p34: figure]

The stepper motor needs to run at minimum torque because at the ends of the aperture range the aperture gears simply grind to a halt and stall the motor. I added a resistor to the motor power supply circuit, starting with 220 ohm and working my way down until I got a reliable result at 39 ohm. Video:
https://www.youtube.com/watch?v=LW8At6LlgP0
END of Mods
Mod-8 Project documents © 2025, 2026 by John Calder are licensed under CC BY 4.0. Creative Commons Attribution.
To view a copy of this license, visit https://creativecommons.org/licenses/by/4.0/
Attribution means: “indicate if changes were made” and “appropriate credit”.
“indicate if changes were made”. You can do this with wording like:
“based on content from https://mod-8-film.com ”
“some ideas from https://mod-8-film.com “

Aperture

Araldite
and
J B Weld
fastening

New stepper
motor

Viewfinder
aerial image
lens, mask
and aperture
scale display

Or source referencing in academic or Wikipedia style.

Attribution also means.
“appropriate credit”. John aims to make this easy by asking only for reference to: https://mod-8-film.com for links.
In text “mod-8-film.com” is OK.
In very plain English:
Freely shared information but say “thank you” for it!
