iafilm-makers/Mod-8-film/(commit log)

2026-03-29 Add files via upload
    Details of modifying old Super-8mm cameras to achieve Mod-8.
2026-05-14 Add files via upload
    Code for first successful runs of camera "Prototype One" as at 13 May 2026
2026-05-14 Update readme with camera code descriptions
    Added descriptions for camera prototype code and testing.
2026-06-07 Add new file via upload
    MCU and mechatronic drivers
